mokomull/dsp-dev-board/DX07S016JA1R1500/DX07S016JA1R1500.step

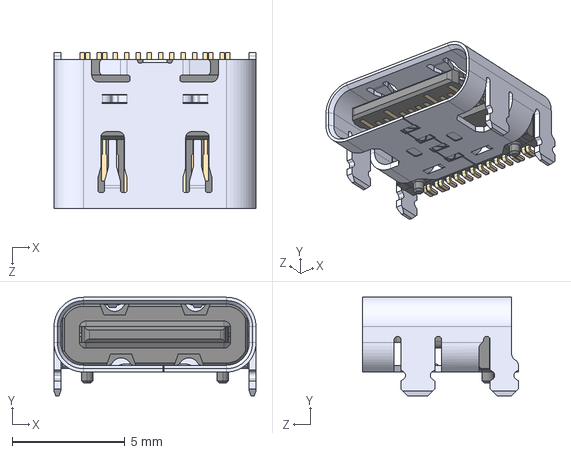
[picture p1: CAD file, 2021-02-14]
DX07S016JA1R1500/DX07S016JA1R1500.step
8.94 x 4.36 x 6.90 mm
