mokomull/dsp-dev-board/TS-1187A-B-A-B/TS-1187A-B-A-B.step

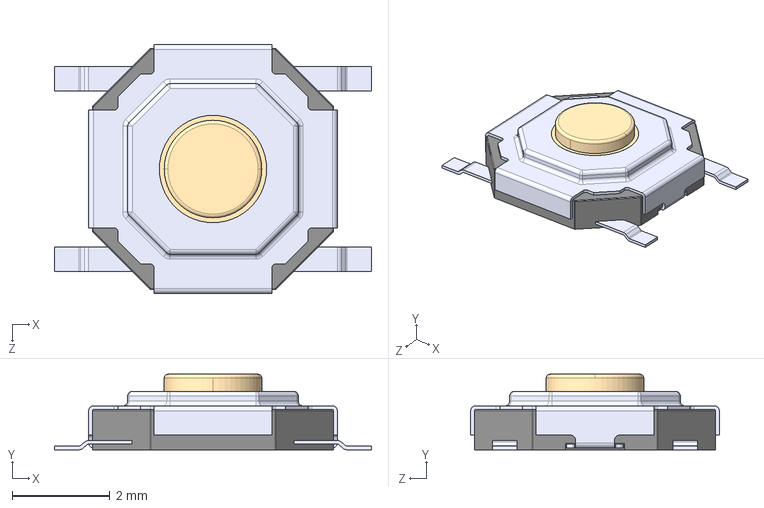
[picture p2: CAD file, 2021-02-14]
TS-1187A-B-A-B/TS-1187A-B-A-B.step
6.50 x 1.55 x 5.10 mm
