mokomull/dsp-dev-board/dsp_dev_board.kicad_pcb

## KiCad design dsp_dev_board.kicad_pcb (2021-04-30)

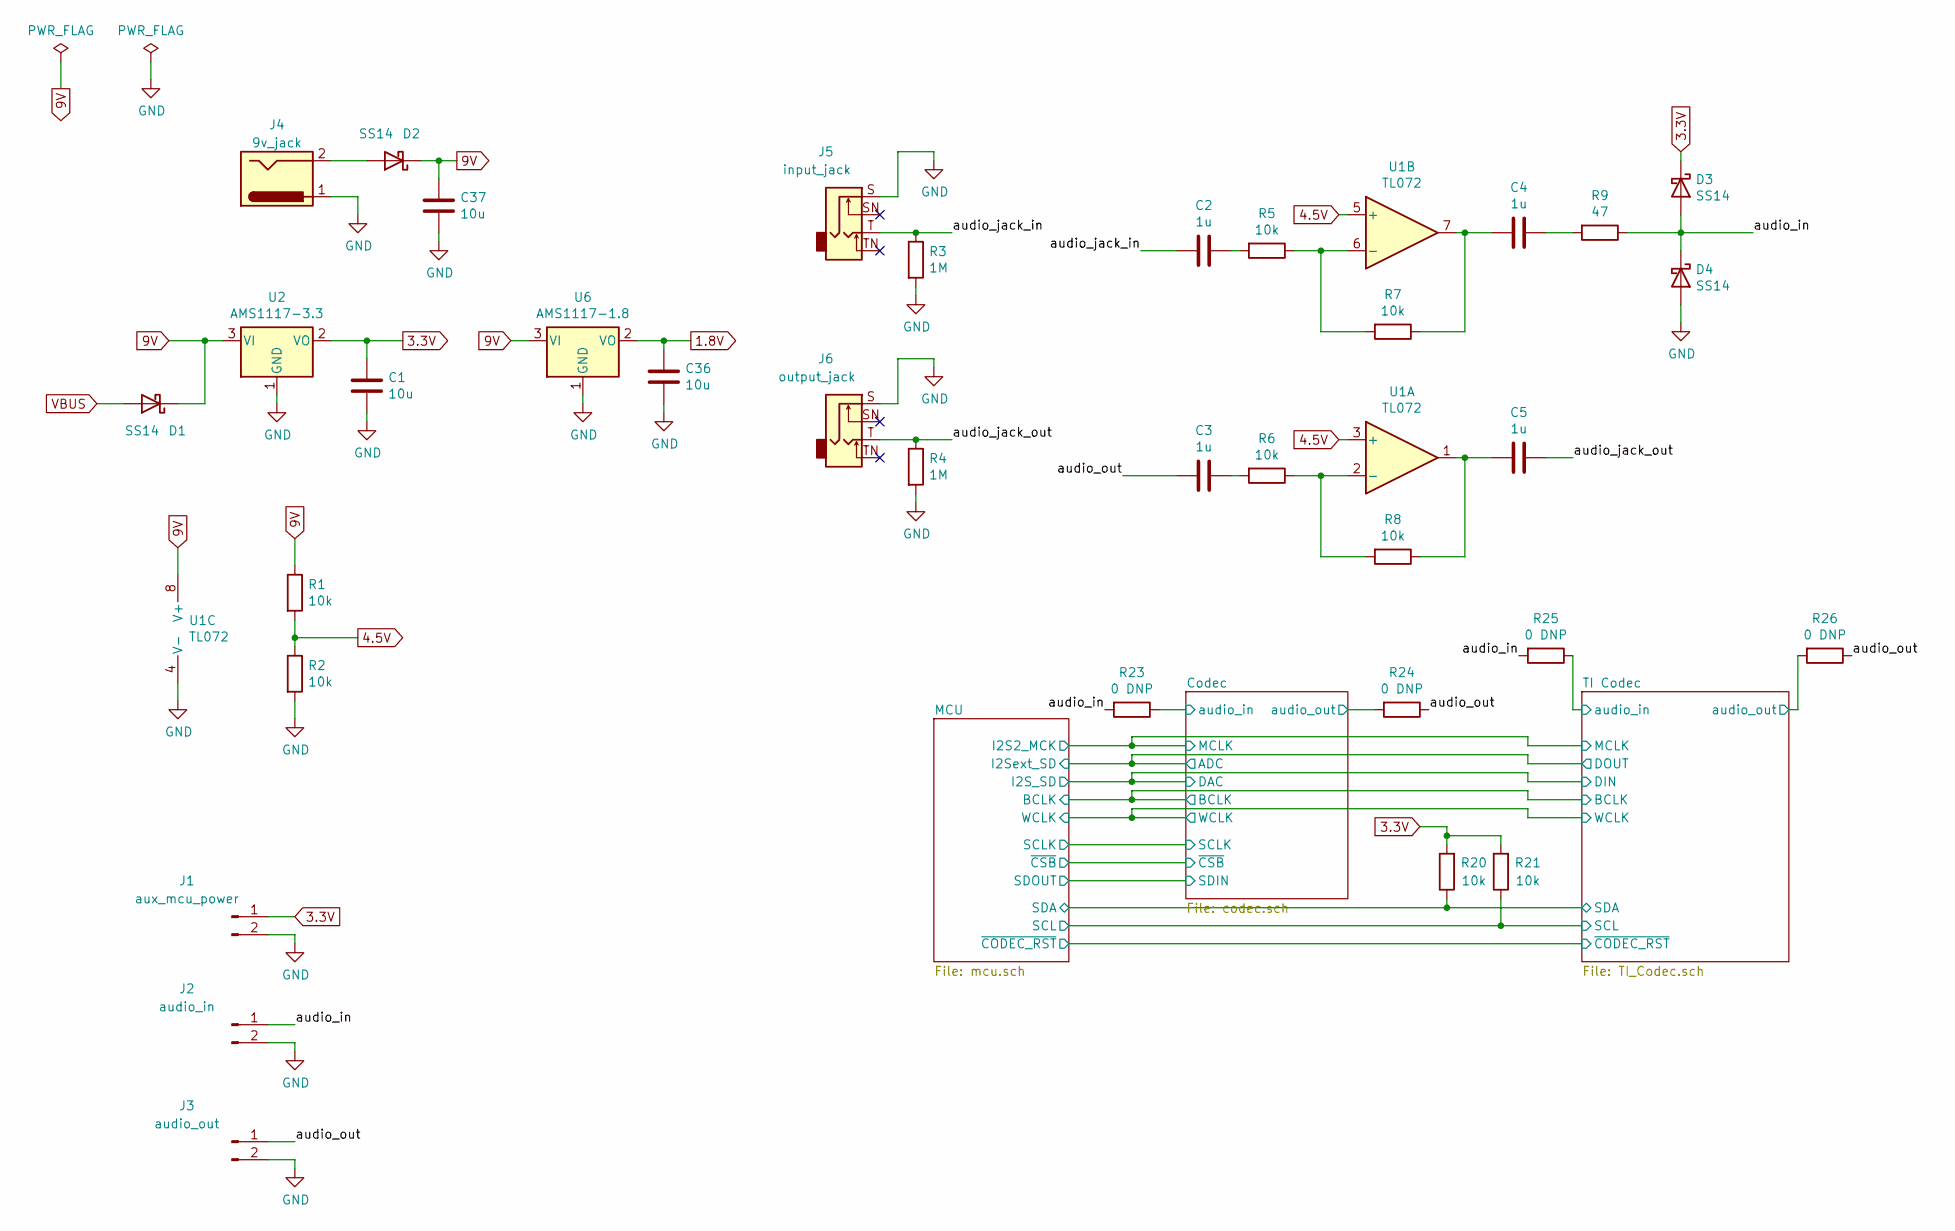
[picture p3: schematic dsp_dev_board.sch]

Parts:
C1, C36, C37: 10u; C_1206_3216Metric
C2, C3, C4, C5: 1u; C_0805_2012Metric
D1, D2, D3, D4: SS14; D_SMA
J1: aux_mcu_power; PinHeader_1x02_P2.54mm_Vertical
J2: audio_in; PinHeader_1x02_P2.54mm_Vertical
J3: audio_out; PinHeader_1x02_P2.54mm_Vertical
J4: 9v_jack; BarrelJack_Horizontal
J5: input_jack; Jack_6.35mm_Neutrik_NMJ4HCD2_Horizontal
J6: output_jack; Jack_6.35mm_Neutrik_NMJ4HCD2_Horizontal
R1, R2, R5, R6, R7, R8, R20, R21: 10k; R_0603_1608Metric
R3, R4: 1M; R_0603_1608Metric
R9: 47; R_0603_1608Metric
R23, R24, R25, R26: 0 DNP; R_0603_1608Metric
U1: TL072; SOIC-8_3.9x4.9mm_P1.27mm
U2: AMS1117-3.3; SOT-223-3_TabPin2
U6: AMS1117-1.8; SOT-223-3_TabPin2

Connections:
1.8V: C36.1, U6.2 (VO); also elsewhere on the board
3.3V: C1.1, D3.1 (K), J1.1, R20.2, R21.2, U2.2 (VO); also elsewhere on the board
4.5V: R1.2, R2.1, U1.3 (+), U1.5 (+)
9V: C37.1, D1.1 (K), D2.1 (K), R1.1, U1.8 (V+), U2.3 (VI), U6.3 (VI)
/Codec/audio_in: R23.1; also elsewhere on the board
/Codec/audio_out: R24.2; also elsewhere on the board
/MCU/SCL: R21.1; also elsewhere on the board
/MCU/SDA: R20.1; also elsewhere on the board
/TI Codec/audio_in: R25.1; also elsewhere on the board
/TI Codec/audio_out: R26.2; also elsewhere on the board
/audio_in: D3.2 (A), D4.1 (K), J2.1, R9.1, R23.2, R25.2
/audio_jack_in: C2.2, J5.T, R3.1
/audio_jack_out: C5.1, J6.T, R4.1
/audio_out: C3.2, J3.1, R24.1, R26.1
GND: C1.2, C36.2, C37.2, D4.2 (A), J1.2, J2.2, J3.2, J4.1, J5.S, J6.S, R2.2, R3.2, R4.2, U1.4 (V-), U2.1 (GND), U6.1 (GND); also elsewhere on the board
unnamed: C2.1, R5.2
unnamed: C3.1, R6.2
unnamed: C4.1, R9.2
unnamed: C4.2, R7.1, U1.7
unnamed: C5.2, R8.1, U1.1
unnamed: D2.2 (A), J4.2
unnamed: R5.1, R7.2, U1.6 (-)
unnamed: R6.1, R8.2, U1.2 (-)
VBUS: D1.2 (A); also elsewhere on the board

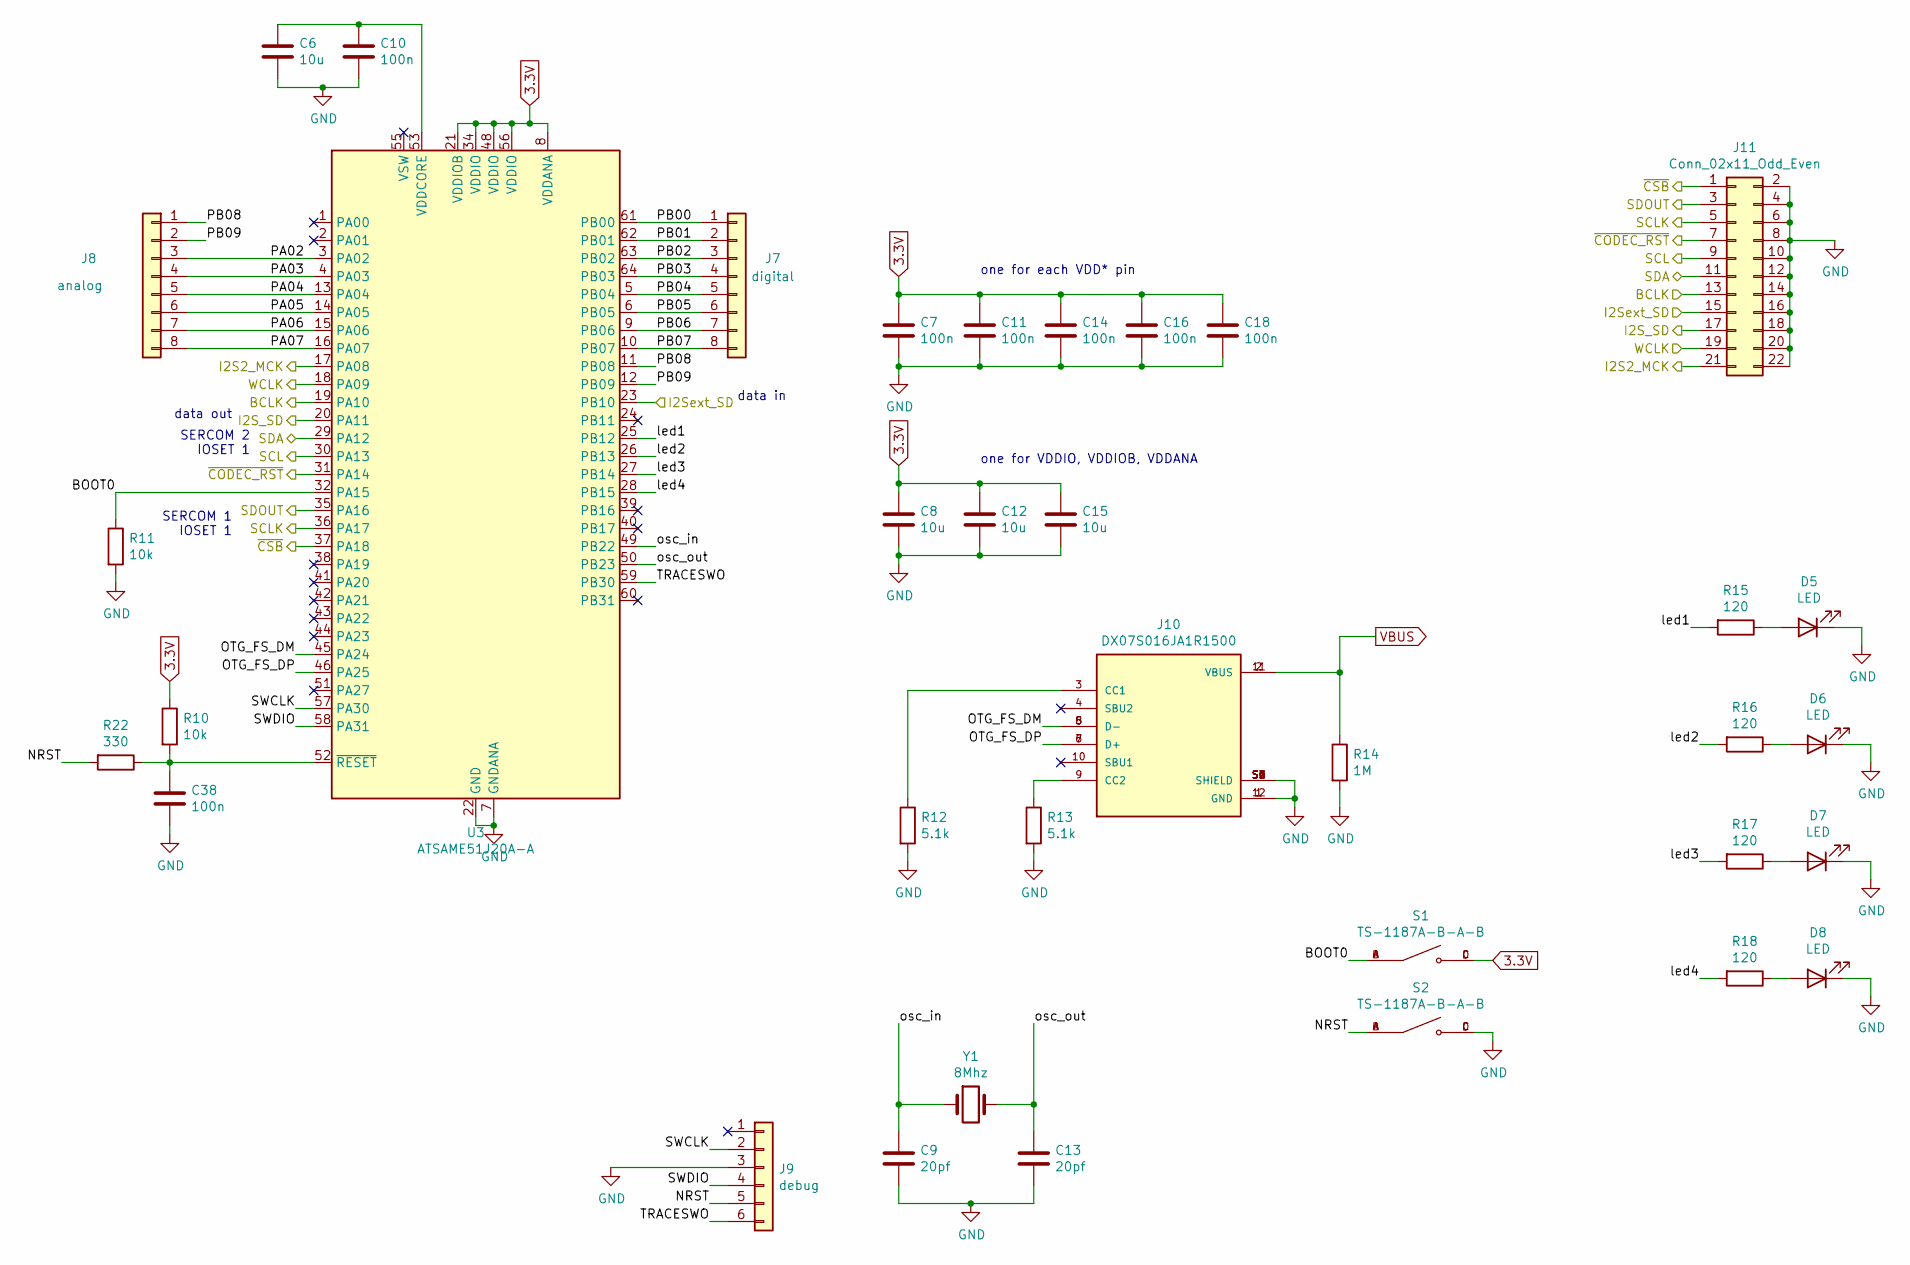
[picture p4: schematic mcu.sch]

Parts:
C6, C8, C12, C15: 10u; C_1206_3216Metric
C7, C10, C11, C14, C16, C18, C38: 100n; C_0603_1608Metric
C9, C13: 20pf; C_0603_1608Metric
D5, D6, D7, D8: LED; LED_0603_1608Metric
J7: digital; PinHeader_1x08_P2.54mm_Vertical
J8: analog; PinHeader_1x08_P2.54mm_Vertical
J9: debug; PinHeader_1x06_P2.54mm_Vertical
J10: DX07S016JA1R1500; JAE_DX07S016JA1R1500; PARTREV 1
J11: Conn_02x11_Odd_Even; PinHeader_2x11_P2.54mm_Vertical
R10, R11: 10k; R_0603_1608Metric
R12, R13: 5.1k; R_0603_1608Metric
R14: 1M; R_0603_1608Metric
R15, R16, R17, R18: 120; R_0603_1608Metric
R22: 330; R_0603_1608Metric
S1, S2: TS-1187A-B-A-B; SW_TS-1187A-B-A-B; PARTREV A0
U3: ATSAME51J20A-A; TQFP-64_10x10mm_P0.5mm
Y1: 8Mhz; Crystal_SMD_5032-2Pin_5.0x3.2mm

Connections:
3.3V: C7.1, C8.1, C11.1, C12.1, C14.1, C15.1, C16.1, C18.1, R10.1, S1.C, S1.D, U3.8 (VDDANA), U3.21 (VDDIOB), U3.34 (VDDIO), U3.48 (VDDIO), U3.56 (VDDIO); also elsewhere on the board
/Codec/ADC: J11.15, U3.23 (PB10); also elsewhere on the board
/Codec/BCLK: J11.13, U3.19 (PA10); also elsewhere on the board
/Codec/DAC: J11.17, U3.20 (PA11); also elsewhere on the board
/Codec/SCLK: J11.5, U3.36 (PA17); also elsewhere on the board
/Codec/SDIN: J11.3, U3.35 (PA16); also elsewhere on the board
/Codec/WCLK: J11.19, U3.18 (PA09); also elsewhere on the board
/Codec/~CSB: J11.1, U3.37 (PA18); also elsewhere on the board
/MCU/BOOT0: R11.1, S1.A, S1.B, U3.32 (PA15)
/MCU/I2S2_MCK: J11.21, U3.17 (PA08); also elsewhere on the board
/MCU/NRST: J9.5, R22.2, S2.A, S2.B
/MCU/OTG_FS_DM: J10.5 (D-), J10.8 (D-), U3.45 (PA24)
/MCU/OTG_FS_DP: J10.6 (D+), J10.7 (D+), U3.46 (PA25)
/MCU/PA02: J8.3, U3.3 (PA02)
/MCU/PA03: J8.4, U3.4 (PA03)
/MCU/PA04: J8.5, U3.13 (PA04)
/MCU/PA05: J8.6, U3.14 (PA05)
/MCU/PA06: J8.7, U3.15 (PA06)
/MCU/PA07: J8.8, U3.16 (PA07)
/MCU/PB00: J7.1, U3.61 (PB00)
/MCU/PB01: J7.2, U3.62 (PB01)
/MCU/PB02: J7.3, U3.63 (PB02)
/MCU/PB03: J7.4, U3.64 (PB03)
/MCU/PB04: J7.5, U3.5 (PB04)
/MCU/PB05: J7.6, U3.6 (PB05)
/MCU/PB06: J7.7, U3.9 (PB06)
/MCU/PB07: J7.8, U3.10 (PB07)
/MCU/PB08: J8.1, U3.11 (PB08)
/MCU/PB09: J8.2, U3.12 (PB09)
/MCU/SCL: J11.9, U3.30 (PA13); also elsewhere on the board
/MCU/SDA: J11.11, U3.29 (PA12); also elsewhere on the board
/MCU/SWCLK: J9.2, U3.57 (PA30)
/MCU/SWDIO: J9.4, U3.58 (PA31)
/MCU/TRACESWO: J9.6, U3.59 (PB30)
/MCU/led1: R15.2, U3.25 (PB12)
/MCU/led2: R16.2, U3.26 (PB13)
/MCU/led3: R17.2, U3.27 (PB14)
/MCU/led4: R18.2, U3.28 (PB15)
/MCU/osc_in: C9.1, U3.49 (PB22), Y1.1
/MCU/osc_out: C13.1, U3.50 (PB23), Y1.2
/MCU/~CODEC_RST: J11.7, U3.31 (PA14); also elsewhere on the board
GND: C6.2, C7.2, C8.2, C9.2, C10.2, C11.2, C12.2, C13.2, C14.2, C15.2, C16.2, C18.2, C38.2, D5.1 (K), D6.1 (K), D7.1 (K), D8.1 (K), J9.3, J10.1 (GND), J10.12 (GND), J10.S1 (SHIELD), J10.S2 (SHIELD), J10.S3 (SHIELD), J10.S4 (SHIELD), J10.S5 (SHIELD), J10.S6 (SHIELD), J11.2, J11.4, J11.6, J11.8, J11.10, J11.12, J11.14, J11.16, J11.18, J11.20, J11.22, R11.2, R12.2, R13.2, R14.2, S2.C, S2.D, U3.7 (GNDANA), U3.22 (GND), U3.33 (GND), U3.47 (GND), U3.54 (GND); also elsewhere on the board
unnamed: C6.1, C10.1, U3.53 (VDDCORE)
unnamed: C38.1, R10.2, R22.1, U3.52 (~RESET)
unnamed: D5.2 (A), R15.1
unnamed: D6.2 (A), R16.1
unnamed: D7.2 (A), R17.1
unnamed: D8.2 (A), R18.1
unnamed: J10.3 (CC1), R12.1
unnamed: J10.9 (CC2), R13.1
VBUS: J10.2 (VBUS), J10.11 (VBUS), R14.1; also elsewhere on the board

Notes on the sheet:
data out
data in
one for each VDD* pin
one for VDDIO, VDDIOB, VDDANA
SERCOM 1 IOSET 1
SERCOM 2 IOSET 1

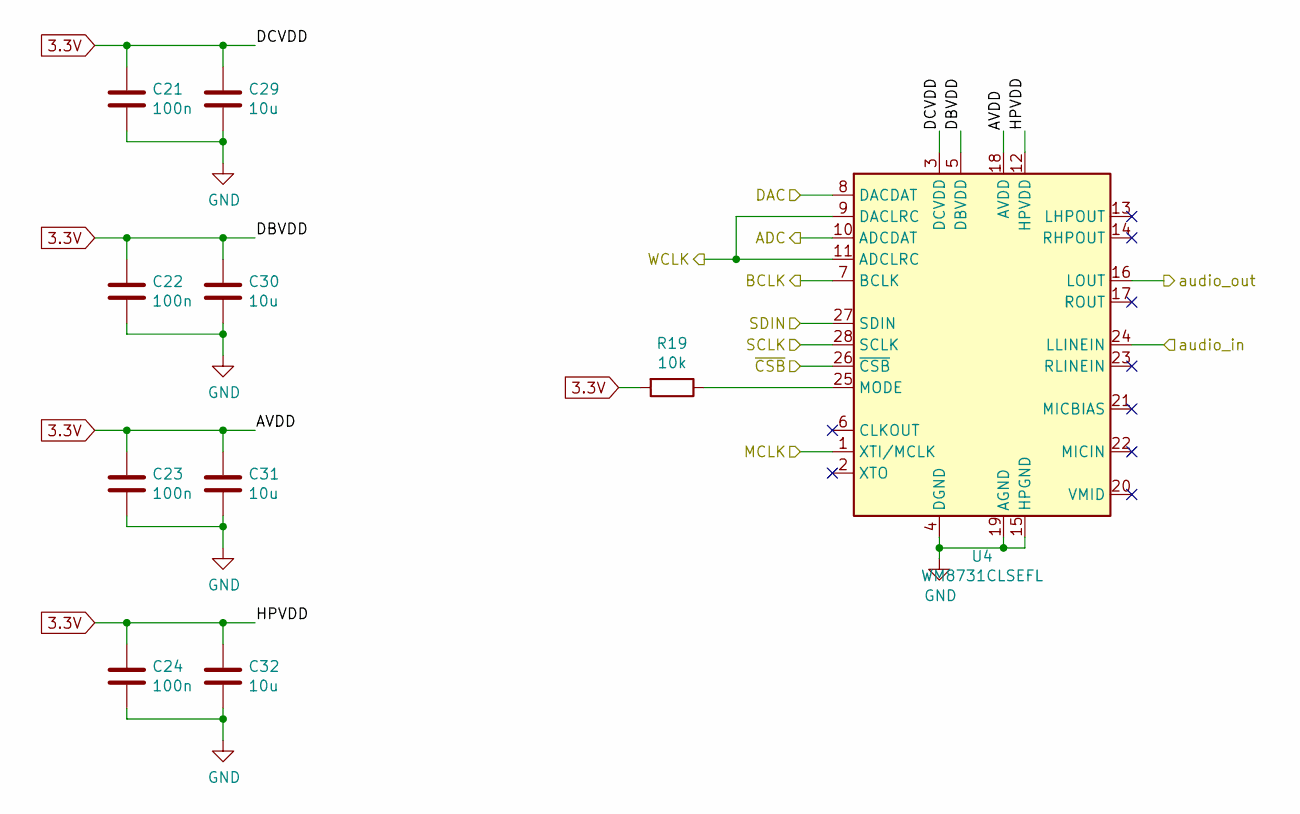
[picture p5: schematic codec.sch]

Parts:
C21, C22, C23, C24: 100n; C_0603_1608Metric
C29, C30, C31, C32: 10u; C_1206_3216Metric
R19: 10k; R_0603_1608Metric
U4: WM8731CLSEFL; QFN-28-1EP_5x5mm_P0.5mm_EP3.35x3.35mm

Connections:
3.3V: C21.1, C22.1, C23.1, C24.1, C29.1, C30.1, C31.1, C32.1, R19.2, U4.3 (DCVDD), U4.5 (DBVDD), U4.12 (HPVDD), U4.18 (AVDD); also elsewhere on the board
/Codec/ADC: U4.10 (ADCDAT); also elsewhere on the board
/Codec/BCLK: U4.7 (BCLK); also elsewhere on the board
/Codec/DAC: U4.8 (DACDAT); also elsewhere on the board
/Codec/SCLK: U4.28 (SCLK); also elsewhere on the board
/Codec/SDIN: U4.27 (SDIN); also elsewhere on the board
/Codec/WCLK: U4.9 (DACLRC), U4.11 (ADCLRC); also elsewhere on the board
/Codec/audio_in: U4.24 (LLINEIN); also elsewhere on the board
/Codec/audio_out: U4.16 (LOUT); also elsewhere on the board
/Codec/~CSB: U4.26 (~CSB); also elsewhere on the board
/MCU/I2S2_MCK: U4.1 (XTI/MCLK); also elsewhere on the board
GND: C21.2, C22.2, C23.2, C24.2, C29.2, C30.2, C31.2, C32.2, U4.4 (DGND), U4.15 (HPGND), U4.19 (AGND), U4.29 (AGND); also elsewhere on the board
unnamed: R19.1, U4.25 (MODE)

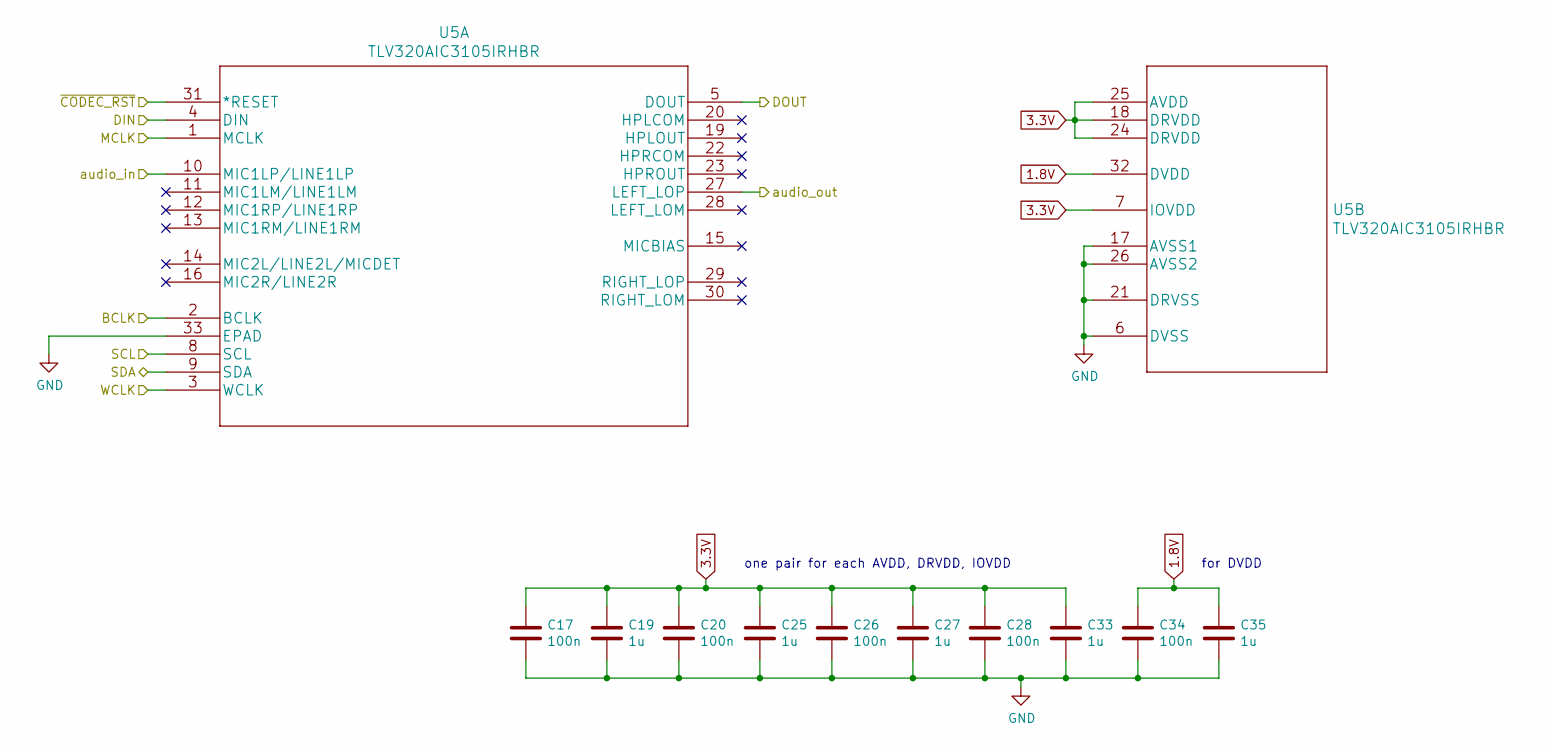
[picture p6: schematic TI_Codec.sch]

Parts:
C17, C20, C26, C28, C34: 100n; C_0603_1608Metric
C19, C25, C27, C33, C35: 1u; C_0805_2012Metric
U5: TLV320AIC3105IRHBR; QFN-32-1EP_5x5mm_P0.5mm_EP3.45x3.45mm_ThermalVias

Connections:
1.8V: C34.1, C35.1, U5.32 (DVDD); also elsewhere on the board
3.3V: C17.1, C19.1, C20.1, C25.1, C26.1, C27.1, C28.1, C33.1, U5.7 (IOVDD), U5.18 (DRVDD), U5.24 (DRVDD), U5.25 (AVDD); also elsewhere on the board
/Codec/ADC: U5.5 (DOUT); also elsewhere on the board
/Codec/BCLK: U5.2 (BCLK); also elsewhere on the board
/Codec/DAC: U5.4 (DIN); also elsewhere on the board
/Codec/WCLK: U5.3 (WCLK); also elsewhere on the board
/MCU/I2S2_MCK: U5.1 (MCLK); also elsewhere on the board
/MCU/SCL: U5.8 (SCL); also elsewhere on the board
/MCU/SDA: U5.9 (SDA); also elsewhere on the board
/MCU/~CODEC_RST: U5.31 (*RESET); also elsewhere on the board
/TI Codec/audio_in: U5.10 (MIC1LP/LINE1LP); also elsewhere on the board
/TI Codec/audio_out: U5.27 (LEFT_LOP); also elsewhere on the board
GND: C17.2, C19.2, C20.2, C25.2, C26.2, C27.2, C28.2, C33.2, C34.2, C35.2, U5.6 (DVSS), U5.17 (AVSS1), U5.21 (DRVSS), U5.26 (AVSS2), U5.33 (EPAD); also elsewhere on the board

Notes on the sheet:
one pair for each AVDD, DRVDD, IOVDD
for DVDD

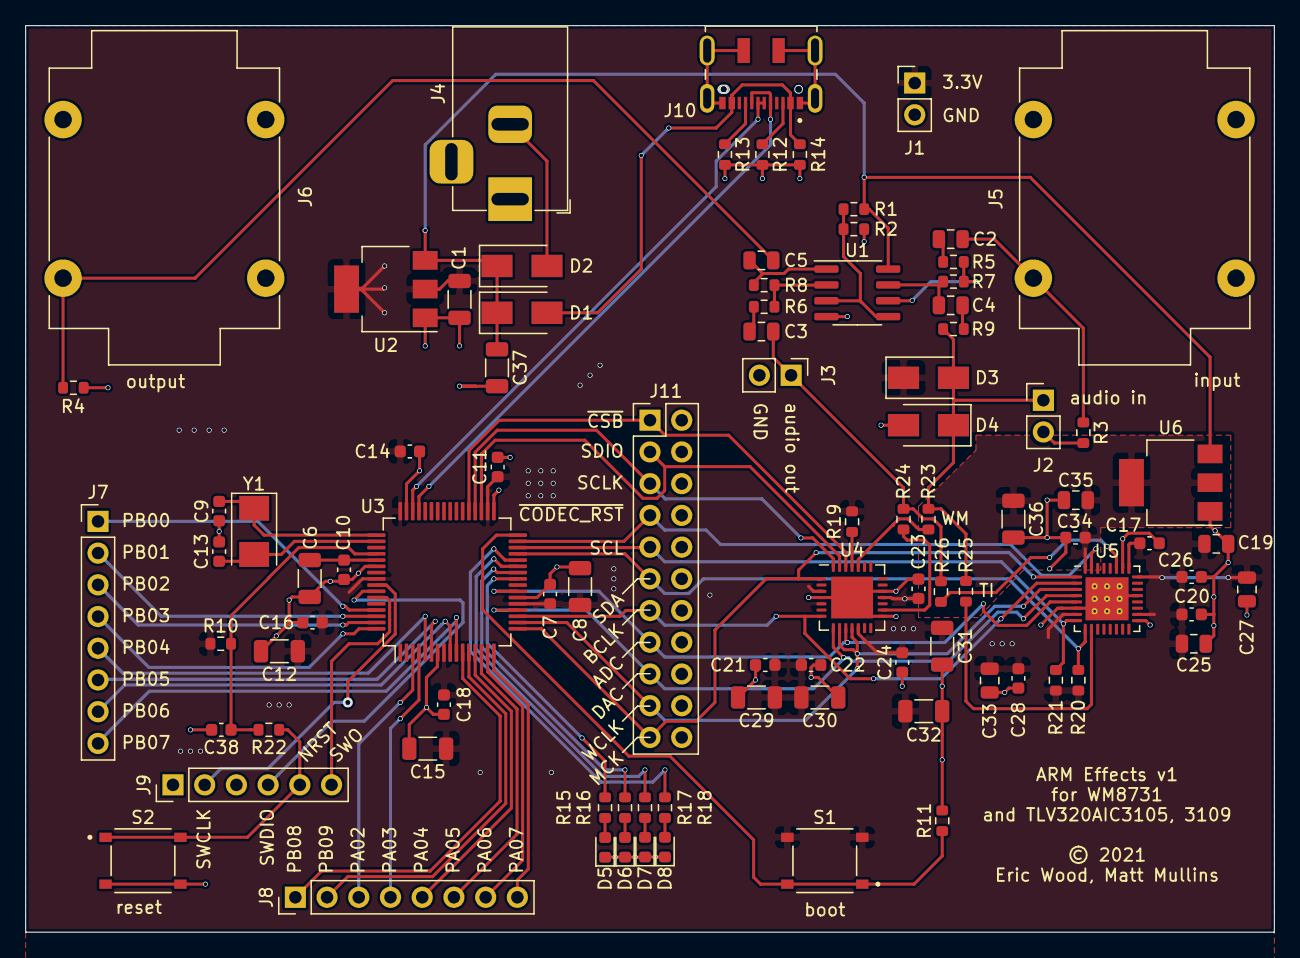
[picture p7: board dsp_dev_board.kicad_pcb from above]

Board: 4 copper layers, 100.0 x 72.6 mm, 92 parts (0 on the bottom side), 71 nets.
