mokomull/dsp-dev-board/dsp_dev_board_2layer.kicad_pcb

## KiCad design dsp_dev_board_2layer.kicad_pcb (2021-04-13)

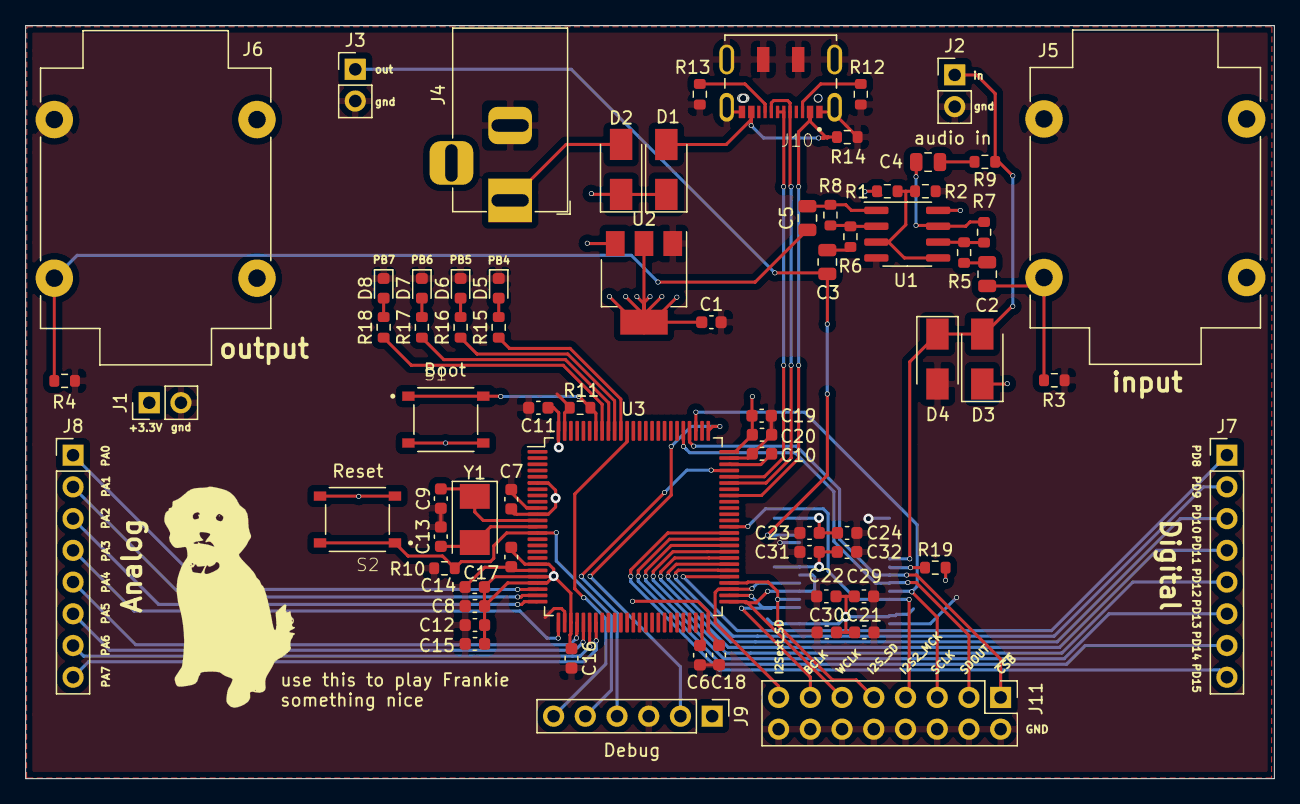
[picture p8: board dsp_dev_board_2layer.kicad_pcb from above]

Board: 2 copper layers, 100.0 x 60.3 mm, 73 parts (1 on the bottom side), 63 nets.

Parts:
C1, C21, C22, C23, C24: 0.1u; C_0603_1608Metric
C2, C3, C4, C5: 1u; C_0805_2012Metric
C6, C10: 2.2u; C_0603_1608Metric
C7, C11, C12, C14, C16, C17, C18, C19: 100n; C_0603_1608Metric
C8, C15: 1u; C_0603_1608Metric
C9, C13: 20pf; C_0603_1608Metric
C20: 4.7u; C_0603_1608Metric
C29, C30, C31, C32: 10u; C_0603_1608Metric
D1, D2, D3, D4: SS14; D_SMA
D5, D6, D7, D8: LED; LED_0603_1608Metric
J1: aux_mcu_power; PinHeader_1x02_P2.54mm_Vertical
J2: audio_in; PinHeader_1x02_P2.54mm_Vertical
J3: audio_out; PinHeader_1x02_P2.54mm_Vertical
J4: 9v_jack; BarrelJack_Horizontal
J5: input_jack; Jack_6.35mm_Neutrik_NMJ4HCD2_Horizontal
J6: output_jack; Jack_6.35mm_Neutrik_NMJ4HCD2_Horizontal
J7: PD8-15 (digital); PinHeader_1x08_P2.54mm_Vertical
J8: PA0-7 (analog); PinHeader_1x08_P2.54mm_Vertical
J9: debug; PinHeader_1x06_P2.54mm_Vertical
J10: DX07S016JA1R1500; JAE_DX07S016JA1R1500
J11: Conn_02x08_Odd_Even; PinHeader_2x08_P2.54mm_Vertical
R1, R2, R5, R6, R7, R8, R10, R11, R19: 10k; R_0603_1608Metric
R3, R4, R14: 1M; R_0603_1608Metric
R9: 47; R_0603_1608Metric
R12, R13: 5.1k; R_0603_1608Metric
R15, R16, R17, R18: 120; R_0603_1608Metric
S1, S2: TS-1187A-B-A-B; SW_TS-1187A-B-A-B
U1: TL072; SOIC-8_3.9x4.9mm_P1.27mm
U2: AMS1117-3.3; SOT-223-3_TabPin2
U3: STM32F407VETx; LQFP-100_14x14mm_P0.5mm
U4: WM8731SEDS; SSOP-28_5.3x10.2mm_P0.65mm
Y1: 8Mhz; Crystal_SMD_5032-2Pin_5.0x3.2mm

Connections:
3.3V: C1.1, C7.1, C8.1, C11.1, C12.1, C14.1, C15.1, C16.1, C17.1, C18.1, C19.1, C20.1, C21.1, C22.1, C23.1, C24.1, C29.1, C30.1, C31.1, C32.1, D3.1, J1.1, R19.2, S1.C, S1.D, S2.C, S2.D, U2.2, U3.6, U3.11, U3.19, U3.21, U3.22, U3.28, U3.50, U3.75, U3.100, U4.1, U4.8, U4.14, U4.27
4.5V: R1.2, R2.1, U1.3, U1.5
9V: D1.1, D2.1, R1.1, U1.8, U2.3
/Codec/ADC: J11.15, U3.53, U4.6
/Codec/BCLK: J11.13, U3.52, U4.3
/Codec/DAC: J11.9, U3.54, U4.4
/Codec/SCLK: J11.5, U3.78, U4.24
/Codec/SDIN: J11.3, U3.80, U4.23
/Codec/WCLK: J11.11, U3.51, U4.5, U4.7
/Codec/~CSB: J11.1, U3.79, U4.22
/MCU/BOOT0: R11.1, S1.A, S1.B, U3.94
/MCU/I2S2_MCK: J11.7, U3.63, U4.25
/MCU/NRST: J9.5, R10.1, S2.A, S2.B, U3.14
/MCU/OTG_FS_DM: J10.5, J10.8, U3.70
/MCU/OTG_FS_DP: J10.6, J10.7, U3.71
/MCU/SWCLK: J9.2, U3.76
/MCU/SWDIO: J9.4, U3.72
/MCU/TRACESWO: J9.6, U3.89
/MCU/VCAP_1: C6.1, U3.49
/MCU/VCAP_2: C10.1, U3.73
/MCU/led1: R15.2, U3.90
/MCU/led2: R16.2, U3.91
/MCU/led3: R17.2, U3.92
/MCU/led4: R18.2, U3.93
/MCU/osc_in: C9.1, U3.12, Y1.1
/MCU/osc_out: C13.1, U3.13, Y1.2
/audio_in: D3.2, D4.1, J2.1, R9.1, U4.20
/audio_jack_in: C2.2, J5.T, R3.1
/audio_jack_out: C5.1, J6.T, R4.1
/audio_out: C3.2, J3.1, U4.12
GND: C1.2, C6.2, C7.2, C8.2, C9.2, C10.2, C11.2, C12.2, C13.2, C14.2, C15.2, C16.2, C17.2, C18.2, C19.2, C20.2, C21.2, C22.2, C23.2, C24.2, C29.2, C30.2, C31.2, C32.2, D4.2, D5.1, D6.1, D7.1, D8.1, J1.2, J2.2, J3.2, J4.2, J5.S, J6.S, J9.3, J10.1, J10.12, J10.S1, J10.S2, J10.S3, J10.S4, J10.S5, J10.S6, J11.2, J11.4, J11.6, J11.8, J11.10, J11.12, J11.14, J11.16, R2.2, R3.2, R4.2, R10.2, R11.2, R12.2, R13.2, R14.2, U1.4, U2.1, U3.10, U3.20, U3.27, U3.74, U3.99, U4.11, U4.15, U4.28
unnamed: C2.1, R5.2
unnamed: C3.1, R6.2
unnamed: C4.1, R9.2
unnamed: C4.2, R7.1, U1.7
unnamed: C5.2, R8.1, U1.1
unnamed: D2.2, J4.1
unnamed: D5.2, R15.1
unnamed: D6.2, R16.1
unnamed: D7.2, R17.1
unnamed: D8.2, R18.1
unnamed: J7.1, U3.55
unnamed: J7.2, U3.56
unnamed: J7.3, U3.57
unnamed: J7.4, U3.58
unnamed: J7.5, U3.59
unnamed: J7.6, U3.60
unnamed: J7.7, U3.61
unnamed: J7.8, U3.62
unnamed: J8.1, U3.23
unnamed: J8.2, U3.24
unnamed: J8.3, U3.25
unnamed: J8.4, U3.26
unnamed: J8.5, U3.29
unnamed: J8.6, U3.30
unnamed: J8.7, U3.31
unnamed: J8.8, U3.32
unnamed: J10.3, R12.1
unnamed: J10.9, R13.1
unnamed: R5.1, R7.2, U1.6
unnamed: R6.1, R8.2, U1.2
unnamed: R19.1, U4.21
VBUS: D1.2, J10.2, J10.11, R14.1, U3.68
