mokomull/dsp-dev-board/(commit log)

2021-01-14 Initial commit, power section seems ok?
    [dsp_dev_board.kicad_pcb, dsp_dev_board.sch]
2021-01-15 Add codec symbol
    [dsp_dev_board.sch]
2021-01-17 Wire up codec
    [codec.sch, dsp_dev_board.sch, mcu.sch]
2021-01-17 Hook up peripherals
    [dsp_dev_board.sch, mcu.sch]
2021-01-17 Add debug header
    [mcu.sch]
2021-01-18 Use a better codec
    [codec.sch, dsp_dev_board.sch, mcu.sch]
2021-01-20 Power the MCU
    [mcu.sch]
2021-01-24 Coupling caps, crystals
    [dsp_dev_board.sch, mcu.sch]
2021-01-24 Clean things up, add LEDs, aux stuff
    [dsp_dev_board.sch, mcu.sch]
2021-02-13 Various fixes
    [codec.sch, dsp_dev_board.sch, mcu.sch]
2021-02-13 Add debug interface
    [codec.sch, dsp_dev_board.sch, mcu.sch]
2021-02-13 Add traces
    [codec.sch, dsp_dev_board.sch, mcu.sch]
2021-02-14 Use contiguous GPIO pins
    [mcu.sch]
2021-02-14 Improved probe points
    [codec.sch, dsp_dev_board.sch, mcu.sch]
2021-02-14 Assign a bunch of footprints
    [codec.sch, dsp_dev_board.sch, mcu.sch]
2021-02-14 Add tactile switch footprints
    [mcu.sch]
2021-02-14 Move switch library here
    [TS-1187A-B-A-B.step, mcu.sch]
2021-02-14 Add USB connector
    [DX07S016JA1R1500.step, mcu.sch]
2021-02-14 maybe this will work
    [mcu.sch]
2021-02-14 make routing easier
    [mcu.sch]
2021-02-14 Update pins for actual ADC ins
    [mcu.sch]
2021-02-15 those two need to be connected
    [codec.sch]
2021-02-27 just a buncha stuff
    [codec.sch, dsp_dev_board.kicad_pcb, dsp_dev_board.sch]
2021-02-28 USB to go
    [dsp_dev_board.kicad_pcb]
2021-02-28 Lots of cleanup
    [dsp_dev_board.kicad_pcb]
2021-03-07 Basically done?
    [DX07S016JA1R1500.step, dsp_dev_board.kicad_pcb, dsp_dev_board.sch, mcu.sch]
2021-03-07 it's done
    [dsp_dev_board.kicad_pcb]
2021-04-13 4 layer progress
    [dsp_dev_board.kicad_pcb, dsp_dev_board_2layer.kicad_pcb, mcu.sch]
2021-04-13 mcu.sch: replace microcontroller with SAME51J
    The I2S bus is placed according to IOSET 1.
    The ADC inputs are sprinkled around mostly-arbitrarily, but since
    PA00-01 are not connected to either ADC peripheral, this uses PB08-09
    for those two signals. PB08 and 09 are connected to *both* ADCs, so
    they should be sampleable simultaneously if necessary.
    [mcu.sch]
2021-04-15 Wire up SPI control, add TLV320AIC310x and I2C
    The I2C is convenient: if I got it backwards, the SDA and SCL pins are
    reversed between SERCOM 2 and 4.
    [codec.sch, dsp_dev_board.sch, mcu.sch]
2021-04-15 Add pull-up resistors for I2C
    [dsp_dev_board.sch]
2021-04-15 mcu: swap 4.7u VDDCORE cap (C6) for 10u
    There's already 10u all over the board so why not squeeze a bit more out
    of the BOM.
    Also adds a footprint for the 100n next to it (C10).
    [mcu.sch]
2021-04-15 Apply footprint-finder's suggestion for USB-C
    It likes the USB_C: prefix, I guess.
    [mcu.sch]
2021-04-15 "0.1u" -> "100n"; use 1206 10u for bulk decoupling
    The 1206 size has a much better derating-vs-bias-voltage curve.
    [codec.sch, dsp_dev_board.sch, mcu.sch]
2021-04-15 Add a 10u decoupling for the main 9V supply
    [dsp_dev_board.sch]
2021-04-15 Wire up more internal buses to the debug connector
    It'll be nice to scope the I2C bus as well.
    [mcu.sch]
2021-04-15 Add RC to NRST for timing
    The Schematic Checklist, §60.4 "External Reset Circuit" told me to do
    it.
    [mcu.sch]
2021-04-15 re-import USB-C connector
    [DX07S016JA1R1500.step]
2021-04-16 sch: add jumpers to select audio path
    This way the unused codec's audio path won't be dangling as an antenna
    picking up unnecessary noise on the analog side
    [dsp_dev_board.sch]
2021-04-19 Add TI codec schematic page.
    This has actually already gone through a couple revisions, but I never
    added it to git. Oops.
    [TI_Codec.sch]
2021-04-19 PCB: most major layout with both codec footprints
    Surprisingly, I don't hate the really long I2S bus-like formation
    between both footprints, though it does break up both the front and back
    layers in the same orientation.
    [dsp_dev_board.kicad_pcb]
2021-04-19 Annotate schematic symbols
    I forgot to do this when I added the jumper resistors.
    [TI_Codec.sch, dsp_dev_board.sch]
2021-04-19 PCB: update TI's footprint so thermal vias are GND
    They were numbered "V" which KiCad thought should be a different net,
    throwing all sorts of DRC errors. Numbering them all 33 makes it act
    like the built-in footprint with thermal vias.
    [dsp_dev_board.kicad_pcb]
2021-04-21 Use actual parts from Mouser order
    I was able to order the ATSAME51J20A-AU and the WM8731CLSEFL.
    [codec.sch, mcu.sch]
2021-04-24 WIP: QFN all the things
    [dsp_dev_board.kicad_pcb]
2021-04-29 pcb: everything connected, passes DRC
    [dsp_dev_board.kicad_pcb, mcu.sch]
2021-04-29 pcb: enhance bypassing on the left side of MCU
    I stuck the bulk bypassing for VDDIO near pin 56, so nudge those
    capacitors over so the F.Cu layer can connect them, and stitch that
    through with some vias to the B.Cu +3.3V rail.
    [dsp_dev_board.kicad_pcb]
2021-04-29 pcb: nudge stuff around so it looks good
    [dsp_dev_board.kicad_pcb]
2021-04-29 pcb: move silkscreens so they're visible
    Component references should not be over vias or other parts. Move them
    so they're visible, but maintain orientation -- the label is vertical if
    the component is vertical.
    [dsp_dev_board.kicad_pcb]
2021-04-29 pcb: add silkscreens
    This labels the pins for the analog, digital, debug, and probepoint
    headers. I also moved R10 so I could have more room for the digital
    header labels.
    [dsp_dev_board.kicad_pcb]
2021-04-30 pcb: move silkscreen for C1 and C26
    They were under other components.
    [dsp_dev_board.kicad_pcb]
2021-04-30 pcb: minor movements, add more labels
    more silkscreens, move some traces
    [dsp_dev_board.kicad_pcb]
2021-04-30 Swap TI codec footprint for builtin QFN
    5x5mm size, 0.5mm pitch, 3.45mm exposed pad. TI recommends the thermal
    vias, though on something this low-power, I think that's overkill.
    I had to use a copper-fill keepout and manually draw traces to keep the
    pads from being horribly misshaped.
    [TI_Codec.sch, dsp_dev_board.kicad_pcb]
2021-04-30 pcb: move more silkscreens
    I moved C17, so its silkscreen ended up under C19.
    Label the jumpers for WM and TI codecs (and abbreviate to WM because
    "WM8731" doesn't fit in the space I have)
    [dsp_dev_board.kicad_pcb]
2021-04-30 power should be center-negative
    And add attribution text to the PCB
    [dsp_dev_board.kicad_pcb, dsp_dev_board.sch]
2021-04-30 add boot/reset labels for the switches
    [dsp_dev_board.kicad_pcb]
2021-04-30 fab: add fab files from first board order
    [dsp_dev_board-B_Cu.gbr, dsp_dev_board-B_Mask.gbr, dsp_dev_board-B_Paste.gbr, dsp_dev_board-B_SilkS.gbr, dsp_dev_board-Edge_Cuts.gbr, dsp_dev_board-F_Cu.gbr, dsp_dev_board-F_Mask.gbr, dsp_dev_board-F_Paste.gbr]
2021-05-18 firmware: blink LED1 at 2Hz
    It works!
2021-05-19 fw: blink all LEDs in order
2021-05-19 fw: send "hello, world." over SPI
    This will be the configuration channel for the WM8731 codec.
2021-05-19 fw: transmit bit pattern with I2S
    This results in a jittery, but exactly 12.288MHz MCLK, and 48.000kHz
    WCLK.
    [main.rs]
2021-05-19 fw: import WM8731 configuration from echo_pedal
    This is pretty much an exact copy/paste from the echo-pedal experiment,
    with `use` glue to make the names match up exactly as written
    previously.
    It does not quite work, though.
2021-05-31 fw: work around not-actually-blocking SPI impl
    The atsamd_hal blocking SPI implementation blocks until it's in the
    FIFO, not until it's been transmitted. This results in #CS being
    deasserted way too early for the first command, so instead just wait
    long enough to get the command out.
2021-05-31 fw: mono mode still needs txdata to be written
    It seems to ignore the 0 written here (verified with an oscilloscope),
    and does dutifully copy the left channel to the corresponding right
    channel timeslot. But without writing *anything* it eats
    every-other-sample and I was getting 2kHz instead of 1kHz.
