mokomull/dsp-dev-board/(notices)

Notices in the files:
dsp_dev_board.kicad_pcb:
© 2021
